lgitrt/BalancingRobot/STM32Code/BalancingRobot/BalancingRobot.ioc

Mcu.UserName=STM32G474RETx
PA0.GPIO_Label=step_left
PA0.Signal=S_TIM2_CH1
PA10.GPIO_Label=dir_right
PA10.Signal=GPIO_Output
PA13.GPIO_Label=T_SWDIO
PA13.Signal=SYS_JTMS-SWDIO
PA14.GPIO_Label=T_SWCLK
PA14.Signal=SYS_JTCK-SWCLK
PA2.GPIO_Label=LPUART1_TX [STLINKV3E_VCP_RX]
PA2.Signal=LPUART1_TX
PA3.GPIO_Label=LPUART1_RX [STLINKV3E_VCP_TX]
PA3.Signal=LPUART1_RX
PA4.GPIO_Label=motor_enable2
PA4.Signal=GPIO_Output
PA5.GPIO_Label=LD2 [green led]
PA5.Signal=GPIO_Output
PA8.GPIO_Label=step_right
PA8.Signal=S_TIM1_CH1
PA9.GPIO_Label=dir_left
PA9.Signal=GPIO_Output
PB0.GPIO_Label=motor_enable1
PB0.Signal=GPIO_Output
PB3.GPIO_Label=T_SWO
PB3.Signal=SYS_JTDO-SWO
PB8-BOOT0.Signal=I2C1_SCL
PB9.Signal=I2C1_SDA
PC13.GPIO_Label=B1 [blue push button]
PC13.Signal=GPXTI13
PC14-OSC32_IN.Signal=RCC_OSC32_IN
PC15-OSC32_OUT.Signal=RCC_OSC32_OUT
PC6.GPIO_Label=scl_right_enc
PC6.Signal=I2C4_SCL
PC7.GPIO_Label=sda_right_enc
PC7.Signal=I2C4_SDA
PC8.GPIO_Label=scl_left_enc
PC8.Signal=I2C3_SCL
PC9.GPIO_Label=sda_left_enc
PC9.Signal=I2C3_SDA
PF0-OSC_IN.Signal=RCC_OSC_IN
PF1-OSC_OUT.Signal=RCC_OSC_OUT
