lgitrt/BalancingRobot/(commit log)

2026-10-02 Add balancing robot simulation and firmware
    [balancing_world.sdf]
2026-10-03 Add UART motor and IMU diagnostics
2026-10-03 Increase visibility of motor bench test
2026-10-06 Clean up firmware into modules, fix PID, remove test code
    - Split robot_app.c into fault, imu, stepper, encoder, wheel_feedback,
    estimator, controller and comm modules
    - Remove all bench/trace/test modes; keep PID, LQR, the pitch estimators
    (complementary, kalman, offsetkf), the wheel KF feedback and teleop
    - Boot defaults: lqr, hold on, estimator offsetkf, wheelfb kf
    - Fix the PID velocity-loop sign and retune the PID gains (sim + firmware)
    - New firmware host test STM32Code/tests/test_robot.c
    - Regenerate simulation plots and animation
    - Remove experiments/, keep the hardware comparison plots in docs/
    - Rewrite README, simulation and teleop documentation
    [BalancingRobot.ioc, comm.c, comm.h, controller.c, controller.h, encoder.c]
